gauthiier/M-M-M/README

WORK IN PROGRESS...
Motors & Music & Motions (M&M&M)
dviid, bill verplank, jakob bak
