gauthiier/M-M-M/hardware/eagle/v1/mm.controller.v1.pdf

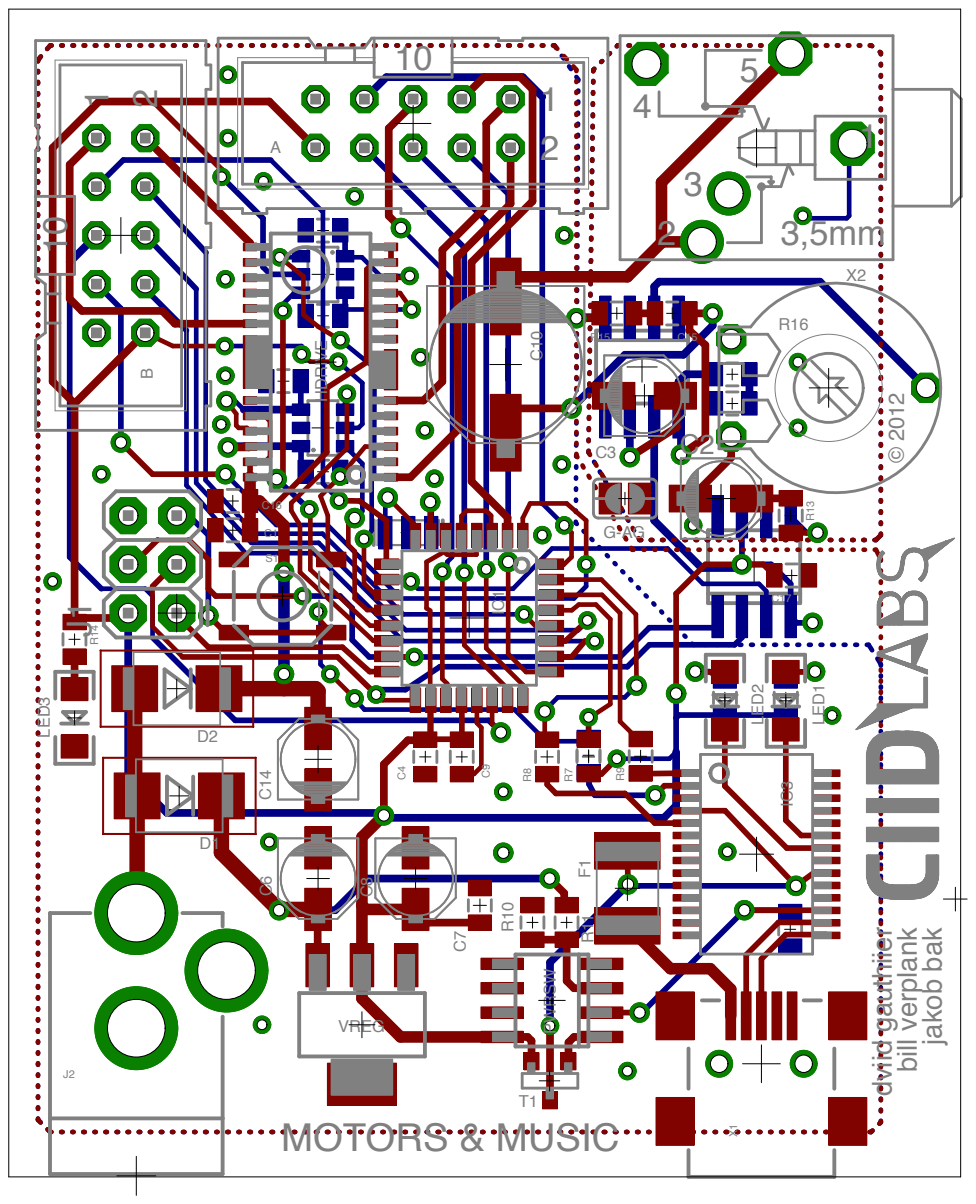
[picture p1: page 1]

bill verplank jakob bak dviid gauthiier © 2012
