gauthiier/M-M-M/hardware/doc/v1/mm.controller.v1-layout.pdf

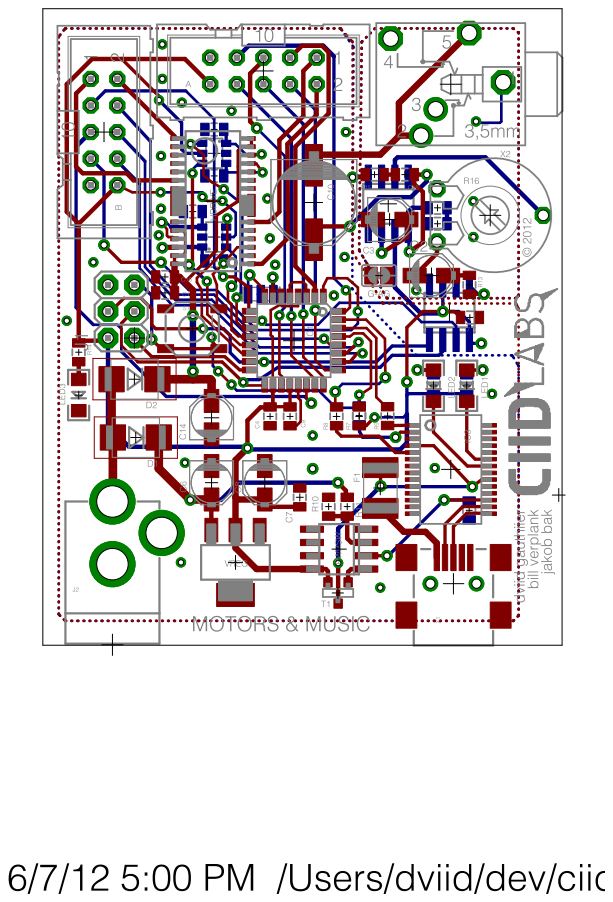
[picture p2: page 1]
