gauthiier/M-M-M/hardware/doc/v1/mm.controller.v1-schema.pdf

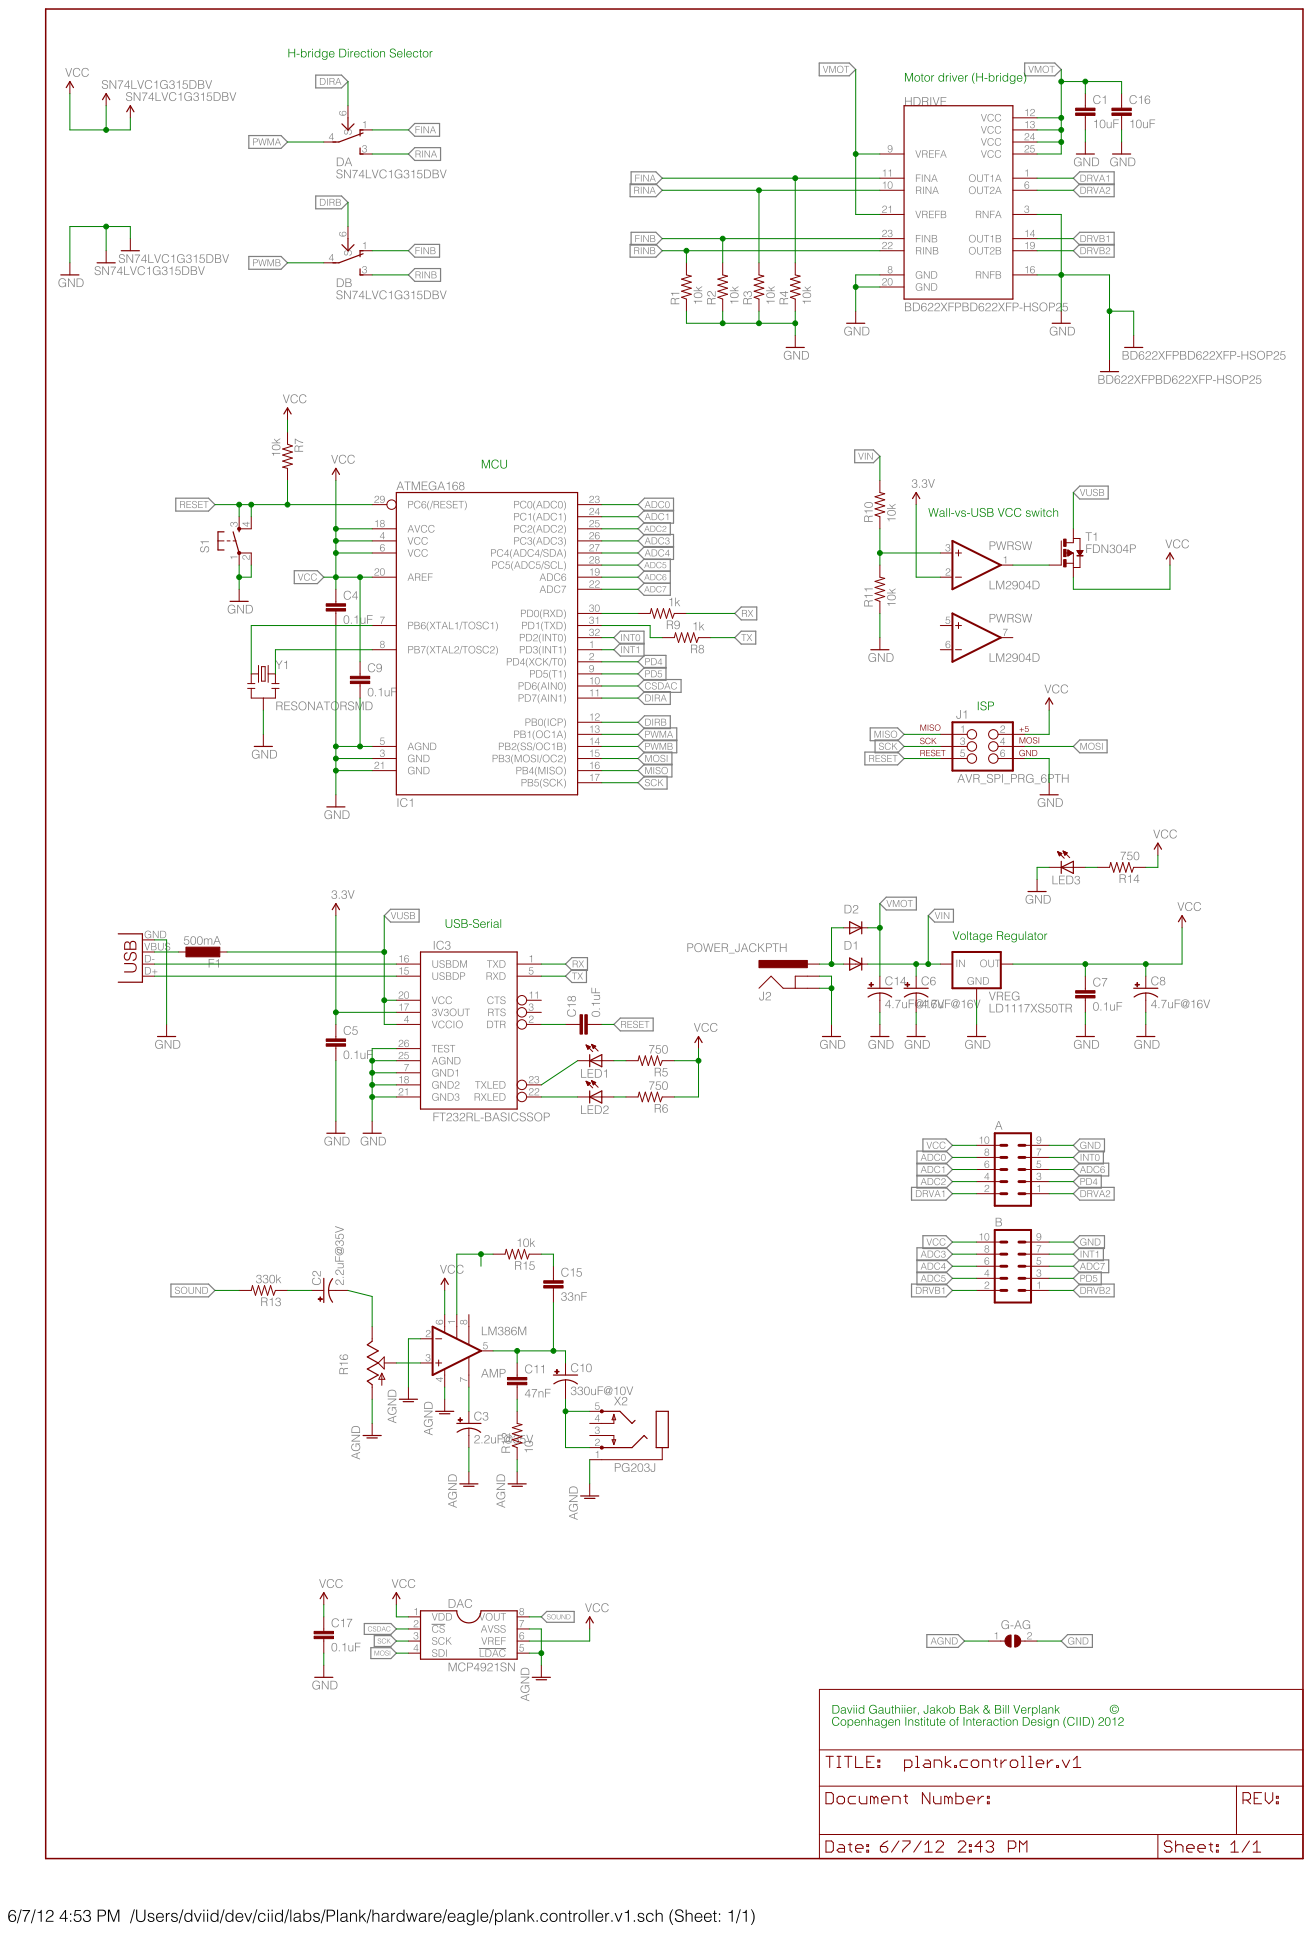
[picture p3: page 1]
