gauthiier/M-M-M/hardware/doc/v0/mm.controller.v0-layout.pdf

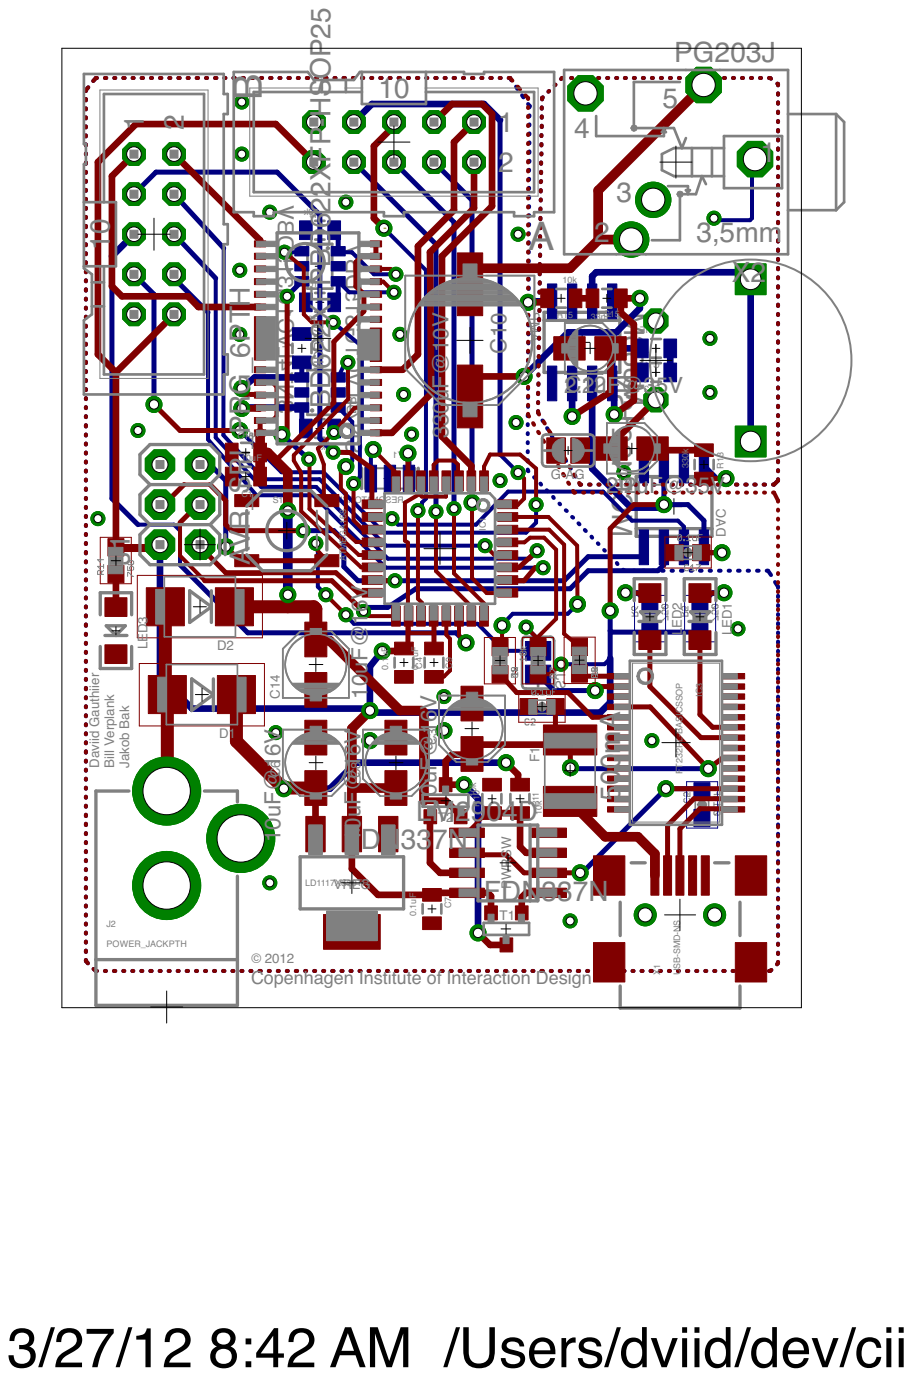
[picture p4: page 1]

Jakob Bak Daviid Gauthiier

FT232RL-BASICSSOP USB-SMD-NS

Copenhagen Institute of Interaction Design

3/27/12 8:42 AM /Users/dviid/dev/cii
