gauthiier/M-M-M/hardware/eagle/v1/mm.controller.v1.brd

## EAGLE design hardware/eagle/v1/mm.controller.v1.brd (2012-11-03)

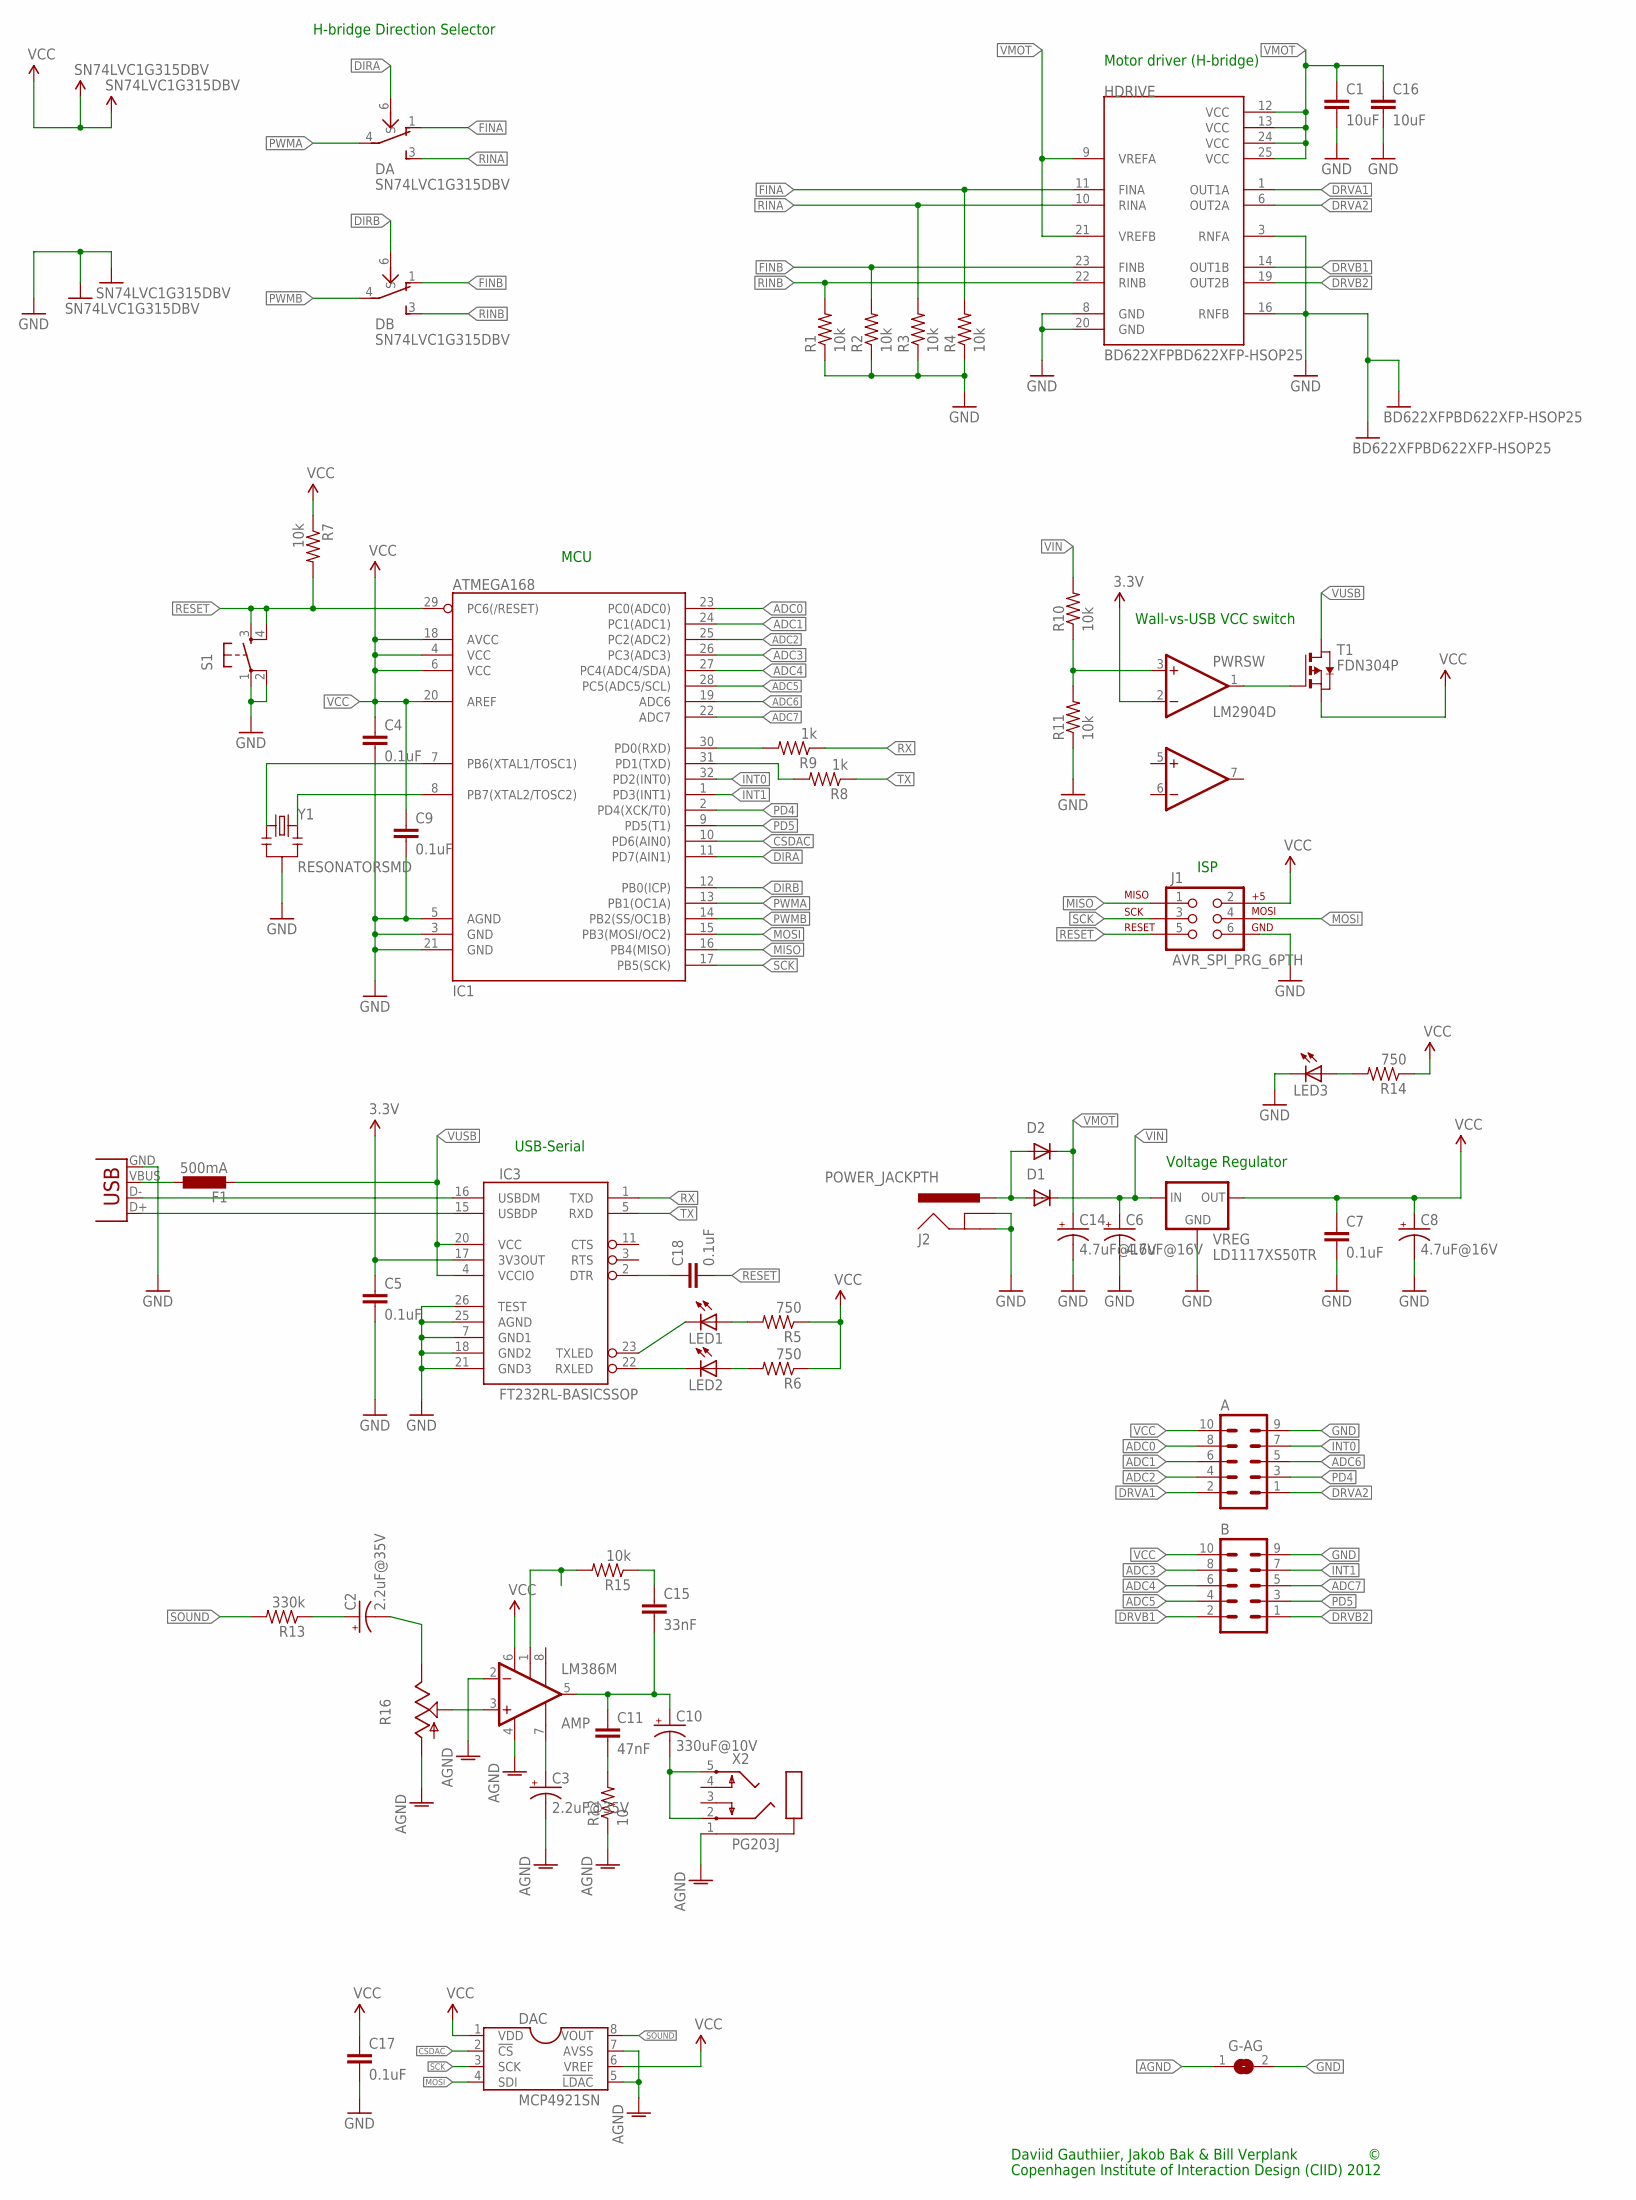
[picture p5: schematic mm.controller.v1.sch]

Parts:
A: ML10
AMP: LM386M; SOIC8
B: ML10
C1, C16: 10uF; 0805
C2, C3: 2.2uF@35V; PANASONIC_B
C4, C5, C7, C9, C17, C18: 0.1uF; 0805
C6, C8, C14: 4.7uF@16V; PANASONIC_B
C10: 330uF@10V; PANASONIC_F
C11: 47nF; 0805
C15: 33nF; 0805
D1, D2: DIODESMB; SMB-DIODE
DA: SN74LVC1G315DBV; SOT23-6
DAC: MCP4921SN; SOIC8
DB: SN74LVC1G315DBV; SOT23-6
F1: 500mA; L1812
G-AG: SJ
HDRIVE: BD622XFPBD622XFP-HSOP25; HSOP25
IC1: ATMEGA168; TQFP32-08
IC3: FT232RL-BASICSSOP; SSOP28DB
J1: AVR_SPI_PRG_6PTH; 2X3
J2: POWER_JACKPTH; POWER_JACK_PTH
LED1, LED2, LED3: LED1206; LED-1206
PWRSW: LM2904D; SOIC8
R1, R2, R3, R4, R7, R10, R11, R15: 10k; 0805
R5, R6, R14: 750; 0805
R8, R9: 1k; 0805
R12: 10; 0805
R13: 330k; 0805
R16: TRIM_US-PT10; PT-10
S1: TAC_SWITCHSMD; TACTILE_SWITCH_SMD
T1: FDN304P; SOT-23
VREG: LD1117XS50TR; SOT223
X1: USB-SMD-NS; USB-MINIB-NOSTOP
X2: PG203J
Y1: RESONATORSMD; RESONATOR-SMD

Connections:
3.3V: C5.1, IC3.17 (3V3OUT), PWRSW.2 (-INA)
ADC0: A.8, IC1.23 (PC0(ADC0))
ADC1: A.6, IC1.24 (PC1(ADC1))
ADC2: A.4, IC1.25 (PC2(ADC2))
ADC3: B.8, IC1.26 (PC3(ADC3))
ADC4: B.6, IC1.27 (PC4(ADC4/SDA))
ADC5: B.4, IC1.28 (PC5(ADC5/SCL))
ADC6: A.5, IC1.19 (ADC6)
ADC7: B.5, IC1.22 (ADC7)
AGND: AMP.2 (-IN), AMP.4 (V-), C3.-, DAC.5 (!LDAC), DAC.7 (AVSS), G-AG.1, R12.1, R16.A, X2.1
CSDAC: DAC.2 (!CS), IC1.10 (PD6(AIN0))
DIRA: DA.6 (S), IC1.11 (PD7(AIN1))
DIRB: DB.6 (S), IC1.12 (PB0(ICP))
DRVA1: A.2, HDRIVE.1 (OUT1A)
DRVA2: A.1, HDRIVE.6 (OUT2A)
DRVB1: B.2, HDRIVE.14 (OUT1B)
DRVB2: B.1, HDRIVE.19 (OUT2B)
FINA: DA.1 (INA), HDRIVE.11 (FINA), R4.2
FINB: DB.1 (INA), HDRIVE.23 (FINB), R2.2
GND: A.9, B.9, C1.2, C4.2, C5.2, C6.-, C7.2, C8.-, C9.2, C14.-, C16.2, C17.2, DA.2 (GND), DB.2 (GND), G-AG.2, HDRIVE.3 (RNFA), HDRIVE.8 (GND), HDRIVE.16 (RNFB), HDRIVE.20 (GND), HDRIVE.GND@1 (GND), HDRIVE.GND@2 (GND), IC1.3 (GND), IC1.5 (AGND), IC1.21 (GND), IC3.7 (GND1), IC3.18 (GND2), IC3.21 (GND3), IC3.25 (AGND), IC3.26 (TEST), J1.6, J2.GND, J2.GNDBREAK, LED3.C, PWRSW.4 (GND), R1.1, R2.1, R3.1, R4.1, R11.1, S1.1, S1.2, VREG.1 (GND), X1.GND, Y1.2
INT0: A.7, IC1.32 (PD2(INT0))
INT1: B.7, IC1.1 (PD3(INT1))
MISO: IC1.16 (PB4(MISO)), J1.1
MOSI: DAC.4 (SDI), IC1.15 (PB3(MOSI/OC2)), J1.4
unnamed: IC1.7 (PB6(XTAL1/TOSC1)), Y1.1
unnamed: IC1.8 (PB7(XTAL2/TOSC2)), Y1.3
unnamed: IC3.16 (USBDM), X1.D-
unnamed: IC3.15 (USBDP), X1.D+
unnamed: IC3.23 (TXLED), LED1.C
unnamed: IC3.22 (RXLED), LED2.C
unnamed: LED1.A, R5.2
unnamed: LED2.A, R6.2
unnamed: F1.1, X1.VBUS
unnamed: IC1.30 (PD0(RXD)), R9.2
unnamed: IC1.31 (PD1(TXD)), R8.2
unnamed: AMP.3 (+IN), R16.S
unnamed: PWRSW.3 (+INA), R10.1, R11.2
unnamed: PWRSW.1 (OUTA), T1.3 (G)
unnamed: LED3.A, R14.2
unnamed: C18.1, IC3.2 (DTR)
unnamed: C2.+, R13.1
unnamed: AMP.5 (OUT), C10.+, C11.1, C15.2
unnamed: C10.-, X2.2, X2.5
unnamed: C11.2, R12.2
unnamed: C15.1, R15.1
unnamed: AMP.1 (G1), R15.2
unnamed: AMP.7 (BYPASS), C3.+
PD4: A.3, IC1.2 (PD4(XCK/T0))
PD5: B.3, IC1.9 (PD5(T1))
PWMA: DA.4 (OUT), IC1.13 (PB1(OC1A))
PWMB: DB.4 (OUT), IC1.14 (PB2(SS/OC1B))
RESET: C18.2, IC1.29 (PC6(/RESET)), J1.5, R7.2, S1.3, S1.4
RINA: DA.3 (INB), HDRIVE.10 (RINA), R3.2
RINB: DB.3 (INB), HDRIVE.22 (RINB), R1.2
RX: IC3.1 (TXD), R9.1
SCK: DAC.3 (SCK), IC1.17 (PB5(SCK)), J1.3
SIN: C2.-, R16.E
SOUND: DAC.8 (VOUT), R13.2
TX: IC3.5 (RXD), R8.1
VCC: A.10, AMP.6 (V+), B.10, C4.1, C7.1, C8.+, C9.1, C17.1, DA.5 (VCC), DAC.1 (VDD), DAC.6 (VREF), DB.5 (VCC), IC1.4 (VCC), IC1.6 (VCC), IC1.18 (AVCC), IC1.20 (AREF), J1.2, PWRSW.8 (VCC), R5.1, R6.1, R7.1, R14.1, T1.2 (S), VREG.2 (OUT)
VIN: C6.+, D1.C, R10.2, VREG.3 (IN)
VMOT: C1.1, C14.+, C16.1, D2.C, HDRIVE.9 (VREFA), HDRIVE.12 (VCC), HDRIVE.13 (VCC), HDRIVE.21 (VREFB), HDRIVE.24 (VCC), HDRIVE.25 (VCC)
VUSB: F1.2, IC3.4 (VCCIO), IC3.20 (VCC), T1.1 (D)
VWALL: D1.A, D2.A, J2.PWR

Notes on the sheet:
Daviid Gauthiier, Jakob Bak & Bill Verplank
Copenhagen Institute of Interaction Design (CIID) 2012
USB-Serial
Voltage Regulator
Wall-vs-USB VCC switch
ISP
MCU
Motor driver (H-bridge)
H-bridge Direction Selector

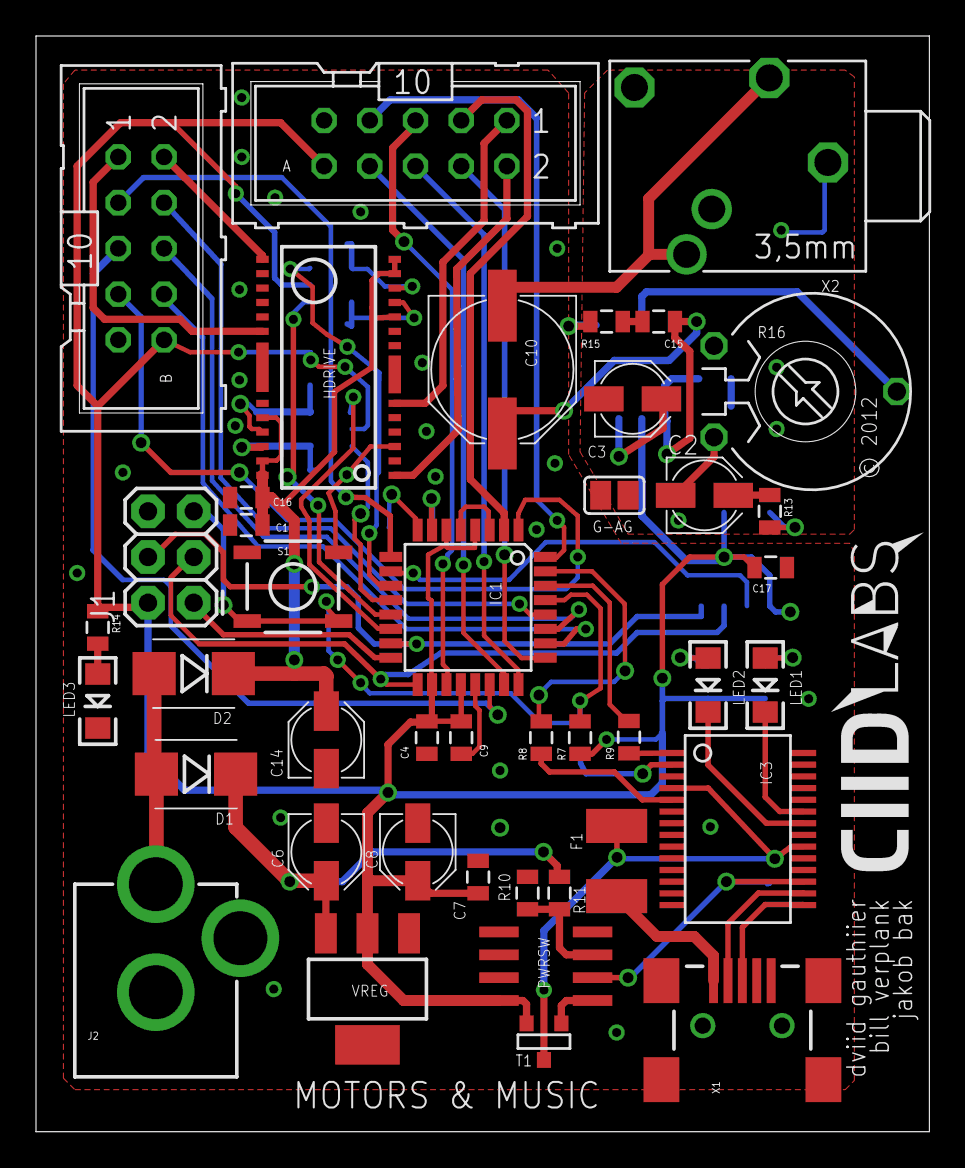
[picture p6: board mm.controller.v1.brd from above]

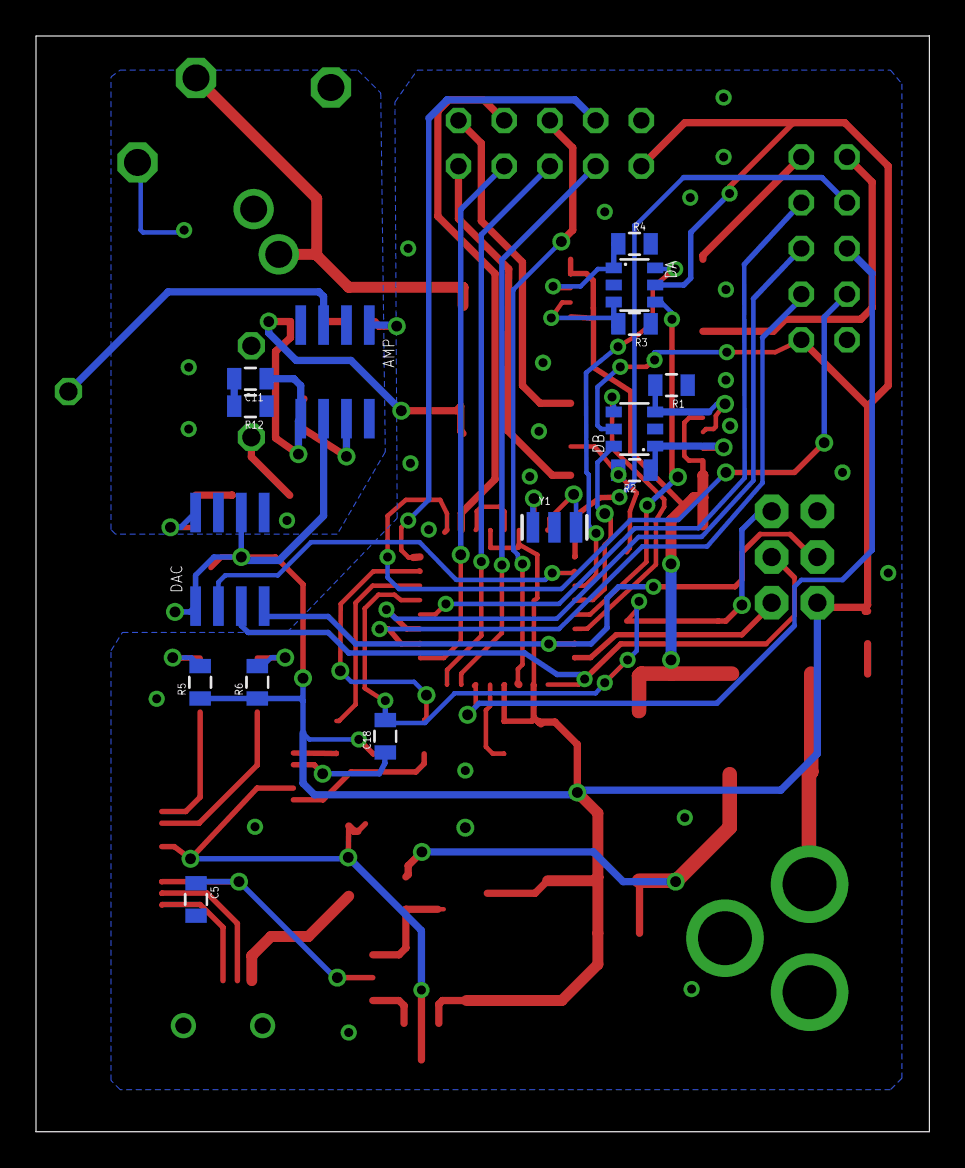
[picture p7: board mm.controller.v1.brd from below]

Board: 2 copper layers, 49.6 x 60.9 mm, 58 parts (15 on the bottom side), 64 nets.

Other parts of the board:
U$2: CIID-LABS-LOGO
