gauthiier/M-M-M/(commit log)

2012-11-04 DampSpringMass code
    none works yet - having trouble with velocity estimation.
2013-01-24 Added some comment text for interrupt select and NUM_OSCILLATORS
2013-01-24 Changes to Motion, Motor and Music Library
    Motion library still needs to be fixed. Don't use yet.
2013-01-28 Updates: Motion + Motor
    Integration with unsyncable branch
2013-01-30 Updates to Music.h, deleted Midi.h and Midi.cpp
    We can now use these commands in the arduino sketch:
    #define NUM_OSCILLATORS x // where x is 1, 2 or 3
    #define BIT_DEPTH x // where x is 8 or 12
    Deleted Midi library files as they where causing multiple definition
    errors with the outdated Music.h file.
2013-02-01 Changed default direction for MOTORB
    Due to hardware design of MM board MOTORA and MOTORB had opposite
    directions. Fixed by switching settings for MOTORB in
    MMotor::direction(DIRECTION) function
2013-02-05 Pulse_Beat.ino
    added to software/lib/MMM/examples/motor/
2013-03-15 Fixed small screen issues
    [Oscilloscope.pde]
2013-05-21 updated library documentation Arduino "sketch"
2013-05-22 fixed _8_FM.ino Arduino sketch
    A conflict in github added some lines of text to the sketch that would
    prevent it from compiling
2013-06-06 Fixed? a problem with MIDI when running Processing sketch Music_Controls and playing notes from sequencer program (like Ableton Live) at the same time.
    [Controller_Functions.pde, Music_Controls_4.pde, midi_handling.pde]
2013-09-26 Added pdf of board layout
2013-09-26 Made some fixes to the MIDI processing sketch and MIDI example
    [Controller_Functions.pde, Music_Controls_4.pde, midi_handling.pde]
